purduerov/X19-Control-Board/Design_Information/board_control_quick_notes.txt

Board Quick Notes:

- There is plenty of space
- The connector location needs to be changed, I am not routing into that

- Aman CAN thing
