purduerov/X19-Control-Board/X19-Control-Board.kicad_pcb

## KiCad design X19-Control-Board.kicad_pcb (2026-11-05)

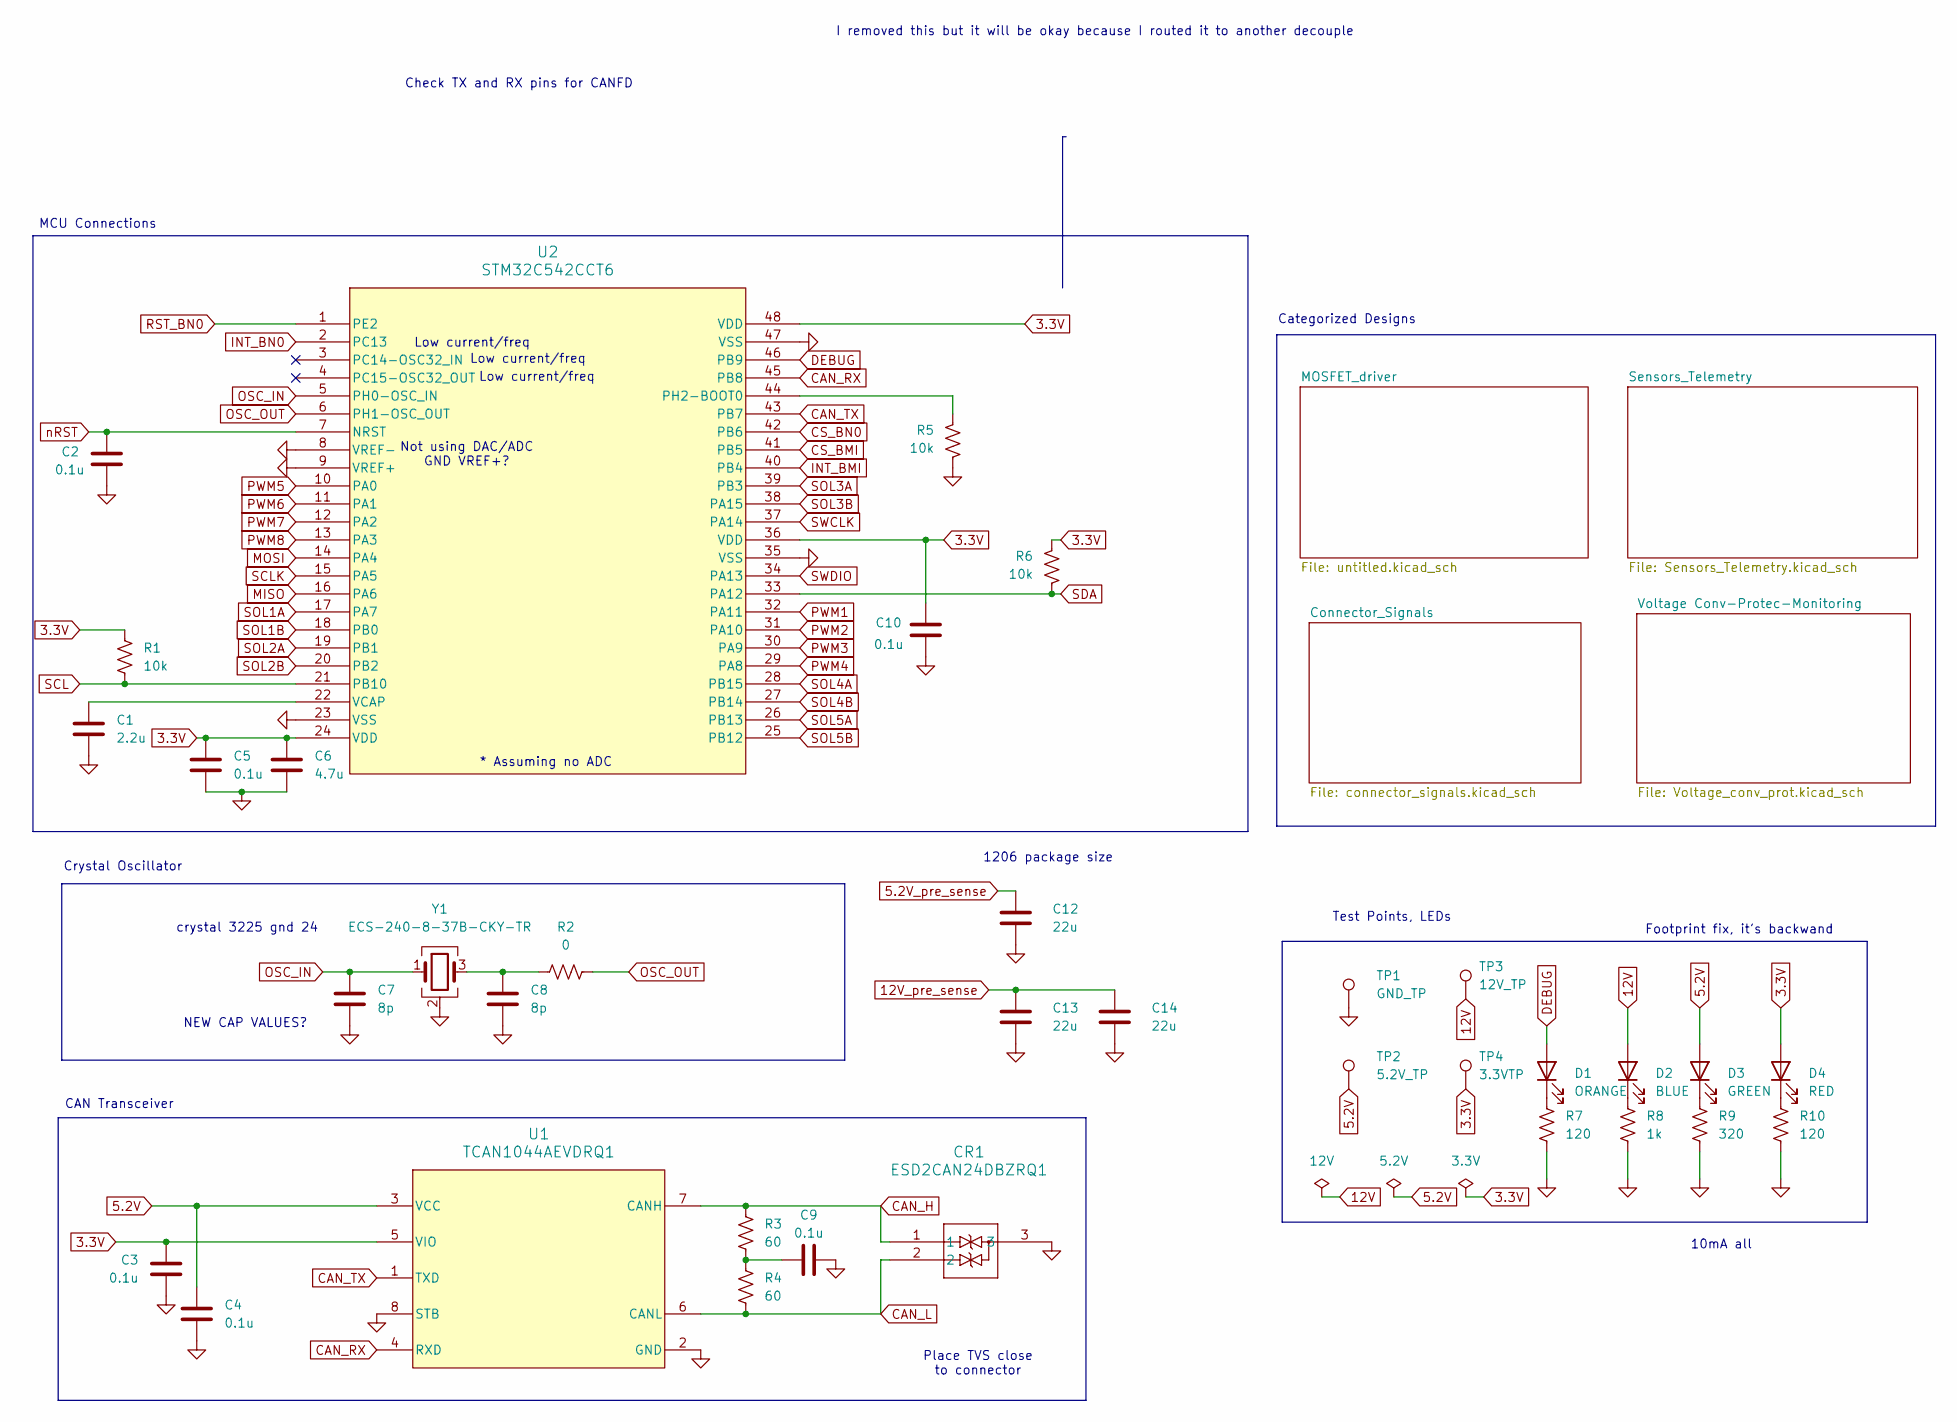
[picture p1: schematic X19-Control-Board.kicad_sch, Purdue ROV Subsystem Board]

Parts:
C1: 2.2u; C_0603_1608Metric_Pad1.08x0.95mm_HandSolder
C2, C3, C4, C5, C9, C10: 0.1u; C_0603_1608Metric_Pad1.08x0.95mm_HandSolder
C6: 4.7u; C_0603_1608Metric_Pad1.08x0.95mm_HandSolder
C7, C8: 8p; C_0603_1608Metric_Pad1.08x0.95mm_HandSolder
C12, C13, C14: 22u; C_1206_3216Metric_Pad1.33x1.80mm_HandSolder
CR1: ESD2CAN24DBZRQ1
D1: ORANGE; LTST-C191KFKT_1_anode_2_cathode
D2: BLUE; LTST-C191KFKT_1_anode_2_cathode
D3: GREEN; LTST-C191KFKT_1_anode_2_cathode
D4: RED; LTST-C191KFKT_1_anode_2_cathode
R1, R5, R6: 10k; R_0603_1608Metric_Pad0.98x0.95mm_HandSolder
R2: 0; R_0603_1608Metric_Pad0.98x0.95mm_HandSolder
R3, R4: 60; R_0603_1608Metric_Pad0.98x0.95mm_HandSolder
R7, R10: 120; R_0603_1608Metric_Pad0.98x0.95mm_HandSolder
R8: 1k; R_0603_1608Metric_Pad0.98x0.95mm_HandSolder
R9: 320; R_0603_1608Metric_Pad0.98x0.95mm_HandSolder
TP1: GND_TP; TestPoint_Pad_D3.0mm
TP2: 5.2V_TP; TestPoint_Pad_D3.0mm
TP3: 12V_TP; TestPoint_Pad_D3.0mm
TP4: 3.3VTP; TestPoint_Pad_D3.0mm
U1: TCAN1044AEVDRQ1
U2: STM32C542CCT6
Y1: ECS-240-8-37B-CKY-TR; ECS-240-8-37CKM_ECS

Connections:
3.3V: C3.1, C5.1, C6.1, C10.2, D4.2 (A), R1.1, R6.1, TP4.1 (1_1), U1.5 (VIO), U2.24 (VDD), U2.36 (VDD), U2.48 (VDD); also elsewhere on the board
5.2V: C4.1, D3.2 (A), TP2.1 (1_1), U1.3 (VCC); also elsewhere on the board
5.2V_pre_sense: C12.1; also elsewhere on the board
12V: D2.2 (A), TP3.1 (1_1); also elsewhere on the board
12V_pre_sense: C13.1, C14.1; also elsewhere on the board
CAN_H: CR1.1, R3.1, U1.7 (CANH); also elsewhere on the board
CAN_L: CR1.2, R4.2, U1.6 (CANL); also elsewhere on the board
CAN_RX: U1.4 (RXD), U2.45 (PB8)
CAN_TX: U1.1 (TXD), U2.43 (PB7)
CS_BMI: U2.41 (PB5); also elsewhere on the board
CS_BN0: U2.42 (PB6); also elsewhere on the board
DEBUG: D1.2 (A), U2.46 (PB9)
GND: C1.2, C2.1, C3.2, C4.2, C5.2, C6.2, C7.2, C8.2, C9.2, C10.1, C12.2, C13.2, C14.2, CR1.3, R5.2, R7.2, R8.2, R9.2, R10.2, TP1.1 (1_1), U1.2 (GND), U1.8 (STB), U2.8 (VREF-), U2.9 (VREF+), U2.23 (VSS), U2.35 (VSS), U2.47 (VSS), Y1.2 (G), Y1.4 (G); also elsewhere on the board
INT_BMI: U2.40 (PB4); also elsewhere on the board
INT_BN0: U2.2 (PC13); also elsewhere on the board
MISO: U2.16 (PA6); also elsewhere on the board
MOSI: U2.14 (PA4); also elsewhere on the board
unnamed: C8.1, R2.1, Y1.3
unnamed: C9.1, R3.2, R4.1
unnamed: D1.1 (K), R7.1
unnamed: D2.1 (K), R8.1
unnamed: D3.1 (K), R9.1
unnamed: D4.1 (K), R10.1
unnamed: R5.1, U2.44 (PH2-BOOT0)
unnamed: C1.1, U2.22 (VCAP)
OSC_IN: C7.1, U2.5 (PH0-OSC_IN), Y1.1
OSC_OUT: R2.2, U2.6 (PH1-OSC_OUT)
PWM1: U2.32 (PA11); also elsewhere on the board
PWM2: U2.31 (PA10); also elsewhere on the board
PWM3: U2.30 (PA9); also elsewhere on the board
PWM4: U2.29 (PA8); also elsewhere on the board
PWM5: U2.10 (PA0); also elsewhere on the board
PWM6: U2.11 (PA1); also elsewhere on the board
PWM7: U2.12 (PA2); also elsewhere on the board
PWM8: U2.13 (PA3); also elsewhere on the board
RST_BN0: U2.1 (PE2); also elsewhere on the board
SCL: R1.2, U2.21 (PB10); also elsewhere on the board
SCLK: U2.15 (PA5); also elsewhere on the board
SDA: R6.2, U2.33 (PA12); also elsewhere on the board
SOL1A: U2.17 (PA7); also elsewhere on the board
SOL1B: U2.18 (PB0); also elsewhere on the board
SOL2A: U2.19 (PB1); also elsewhere on the board
SOL2B: U2.20 (PB2); also elsewhere on the board
SOL3A: U2.39 (PB3); also elsewhere on the board
SOL3B: U2.38 (PA15); also elsewhere on the board
SOL4A: U2.28 (PB15); also elsewhere on the board
SOL4B: U2.27 (PB14); also elsewhere on the board
SOL5A: U2.26 (PB13); also elsewhere on the board
SOL5B: U2.25 (PB12); also elsewhere on the board
SWCLK: U2.37 (PA14); also elsewhere on the board
SWDIO: U2.34 (PA13); also elsewhere on the board
nRST: C2.2, U2.7 (NRST); also elsewhere on the board

Notes on the sheet:
Test Points, LEDs
Low current/freq
I removed this but it will be okay because I routed it to another decouple
CAN Transceiver
* Assuming no ADC
1206 package size
Crystal Oscillator
Not using DAC/ADC GND VREF+?
NEW CAP VALUES?
Check TX and RX pins for CANFD
MCU Connections
10mA all
crystal 3225 gnd 24
Footprint fix, it's backwand
Place TVS close to connector
Categorized Designs

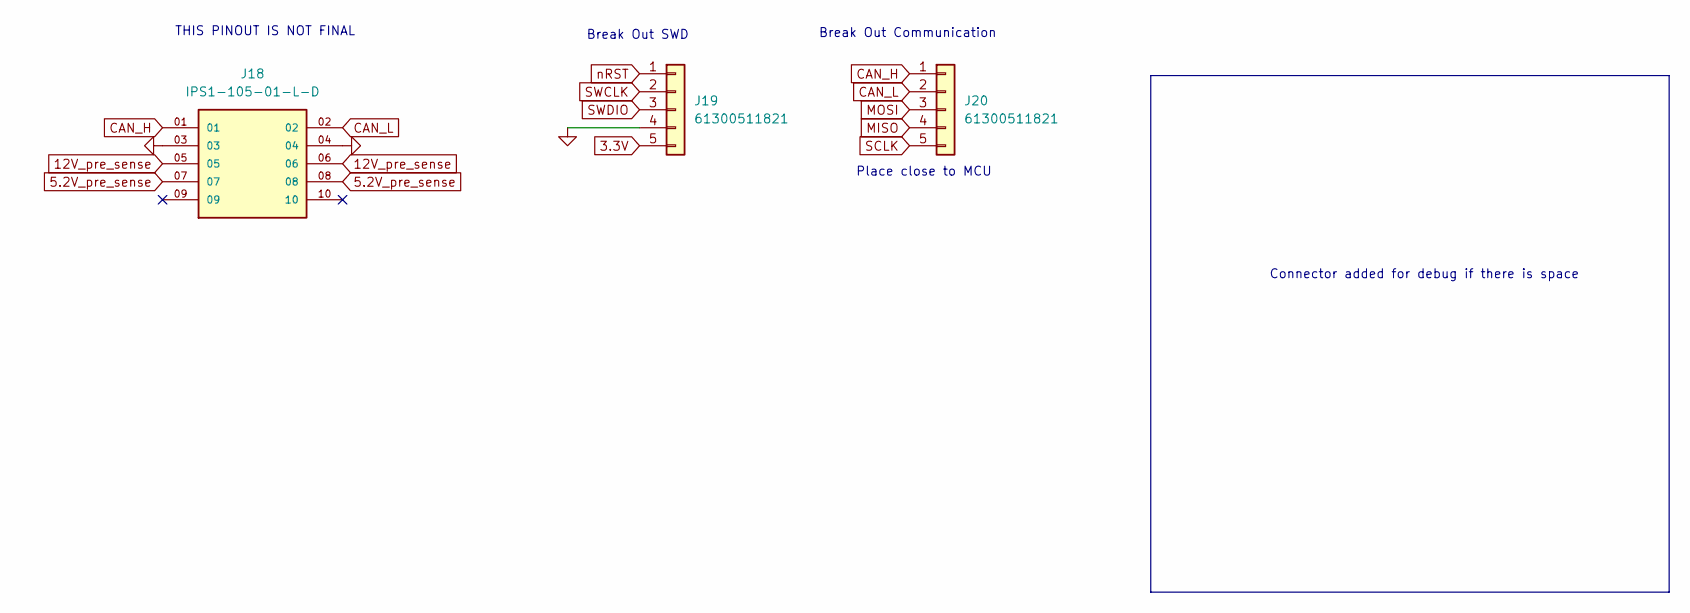
[picture p2: schematic connector_signals.kicad_sch]

Parts:
J18: IPS1-105-01-L-D; SAMTEC_IPS1-105-01-S-D; PARTREV R
J19, J20: 61300511821

Connections:
3.3V: J19.5; also elsewhere on the board
5.2V_pre_sense: J18.07, J18.08; also elsewhere on the board
12V_pre_sense: J18.05, J18.06; also elsewhere on the board
CAN_H: J18.01, J20.1; also elsewhere on the board
CAN_L: J18.02, J20.2; also elsewhere on the board
GND: J18.03, J18.04, J19.4; also elsewhere on the board
MISO: J20.4; also elsewhere on the board
MOSI: J20.3; also elsewhere on the board
SCLK: J20.5; also elsewhere on the board
SWCLK: J19.2; also elsewhere on the board
SWDIO: J19.3; also elsewhere on the board
nRST: J19.1; also elsewhere on the board

Notes on the sheet:
Break Out Communication
Place close to MCU
Connector added for debug if there is space
THIS PINOUT IS NOT FINAL
Break Out SWD

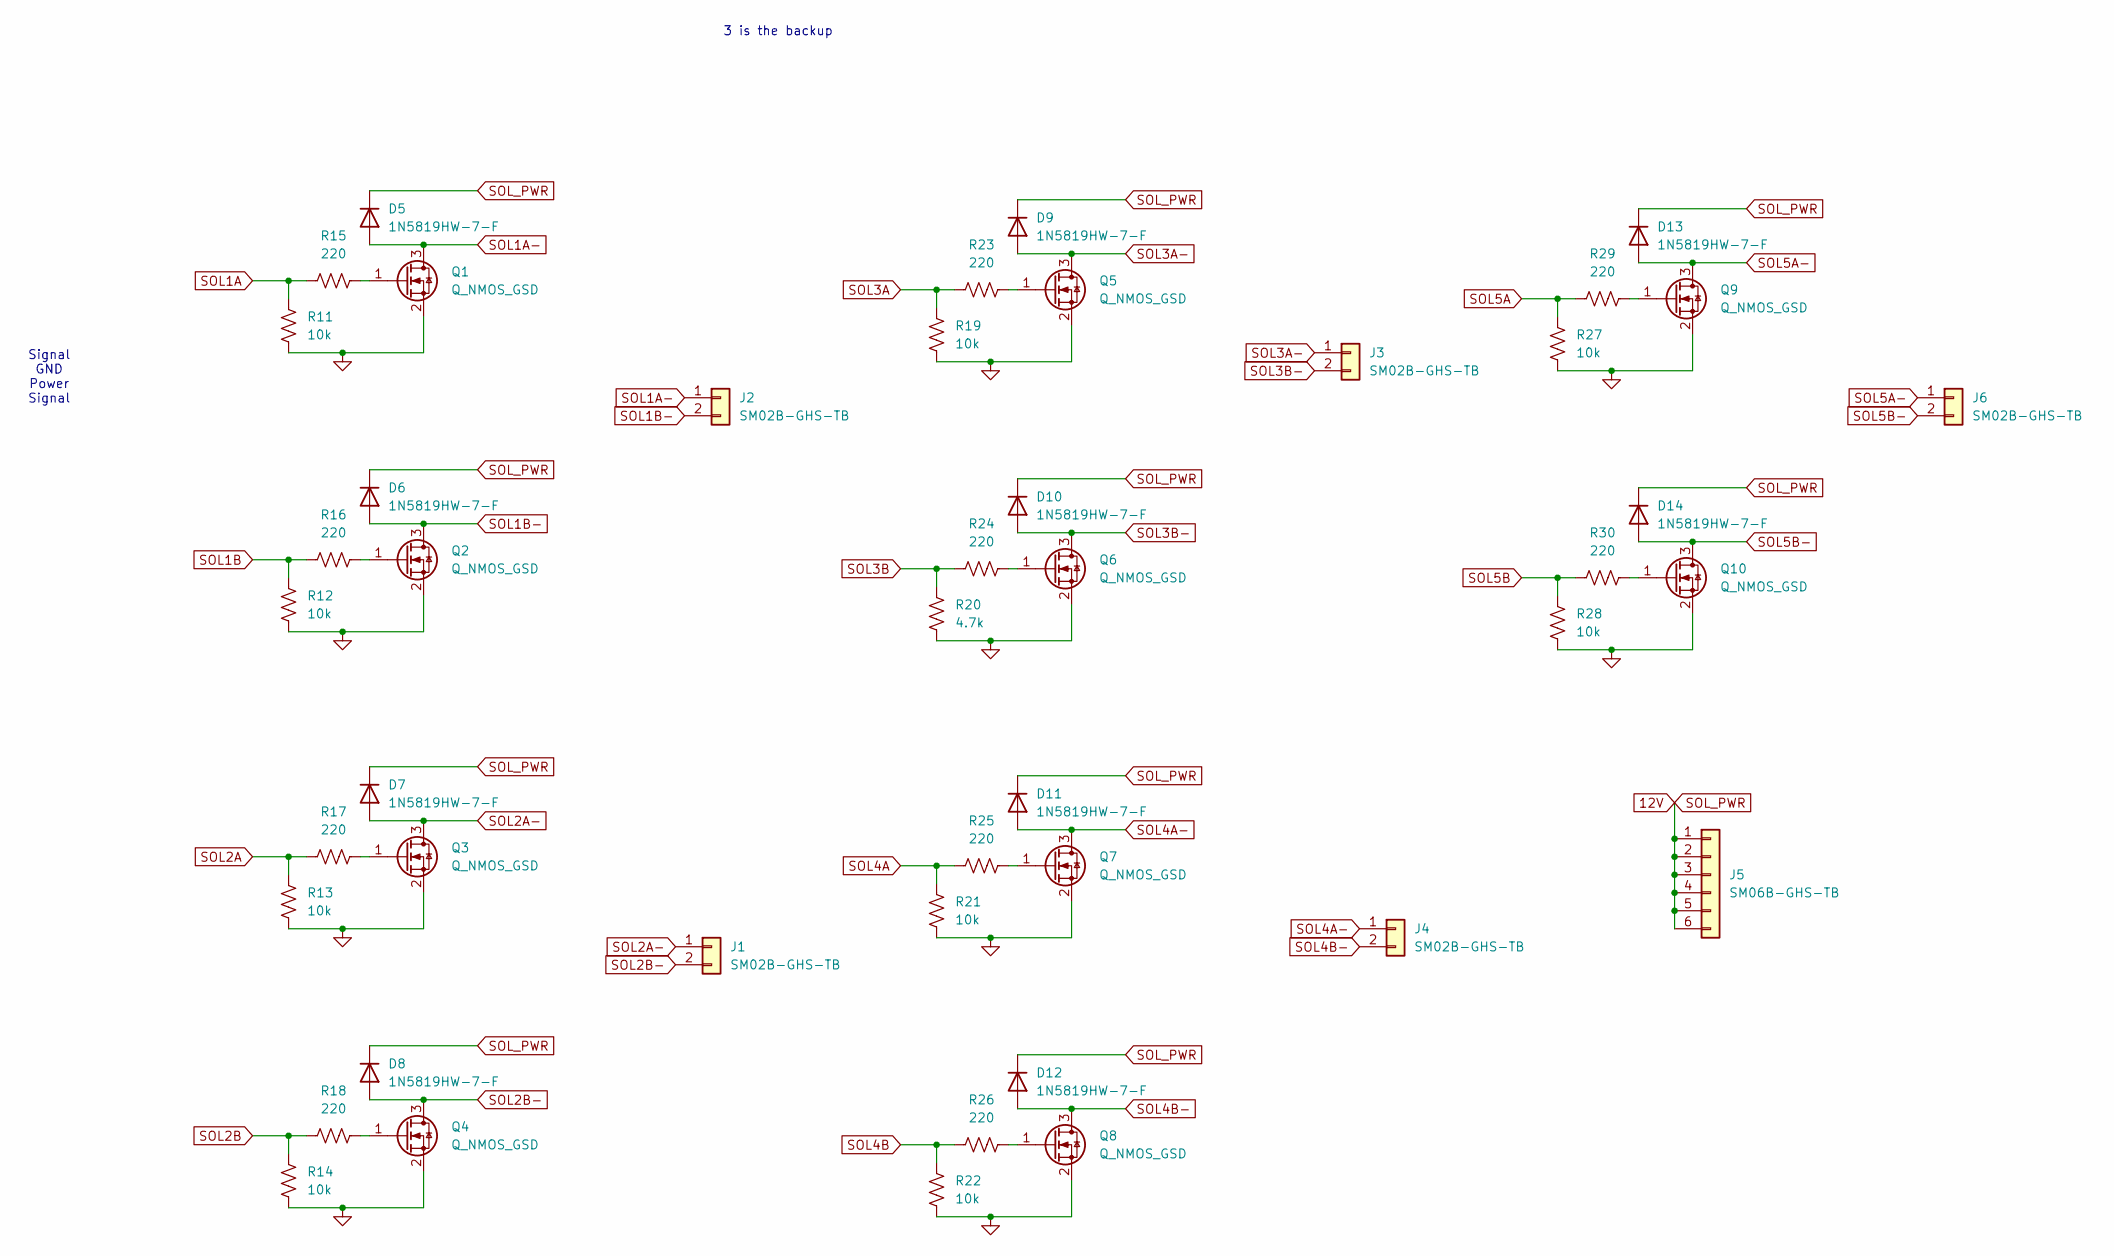
[picture p3: schematic untitled.kicad_sch]

Parts:
D5, D6, D7, D8, D9, D10, D11, D12, D13, D14: 1N5819HW-7-F; 1N5819HW-7-F_DIO
J1, J2, J3, J4, J6: SM02B-GHS-TB; Vertical_CONN_BM02B-GHS-TBT_JST
J5: SM06B-GHS-TB; vertical_CONN_BM06B-GHS-TBT_JST
Q1, Q2, Q3, Q4, Q5, Q6, Q7, Q8, Q9, Q10: Q_NMOS_GSD; SOT-23-3L_AOS
R11, R12, R13, R14, R19, R21, R22, R27, R28: 10k; R_0603_1608Metric_Pad0.98x0.95mm_HandSolder
R15, R16, R17, R18, R23, R24, R25, R26, R29, R30: 220; R_0603_1608Metric_Pad0.98x0.95mm_HandSolder
R20: 4.7k; R_0603_1608Metric_Pad0.98x0.95mm_HandSolder

Connections:
12V: D5.1 (K), D6.1 (K), D7.1 (K), D8.1 (K), D9.1 (K), D10.1 (K), D11.1 (K), D12.1 (K), D13.1 (K), D14.1 (K), J5.1, J5.2, J5.3, J5.4, J5.5, J5.6; also elsewhere on the board
GND: Q1.2 (S), Q2.2 (S), Q3.2 (S), Q4.2 (S), Q5.2 (S), Q6.2 (S), Q7.2 (S), Q8.2 (S), Q9.2 (S), Q10.2 (S), R11.2, R12.2, R13.2, R14.2, R19.2, R20.2, R21.2, R22.2, R27.2, R28.2; also elsewhere on the board
unnamed: Q1.1 (G), R15.2
unnamed: Q2.1 (G), R16.2
unnamed: Q3.1 (G), R17.2
unnamed: Q4.1 (G), R18.2
unnamed: Q5.1 (G), R23.2
unnamed: Q6.1 (G), R24.2
unnamed: Q7.1 (G), R25.2
unnamed: Q8.1 (G), R26.2
unnamed: Q9.1 (G), R29.2
unnamed: Q10.1 (G), R30.2
SOL1A: R11.1, R15.1; also elsewhere on the board
SOL1A-: D5.2 (A), J2.1, Q1.3 (D)
SOL1B: R12.1, R16.1; also elsewhere on the board
SOL1B-: D6.2 (A), J2.2, Q2.3 (D)
SOL2A: R13.1, R17.1; also elsewhere on the board
SOL2A-: D7.2 (A), J1.1, Q3.3 (D)
SOL2B: R14.1, R18.1; also elsewhere on the board
SOL2B-: D8.2 (A), J1.2, Q4.3 (D)
SOL3A: R19.1, R23.1; also elsewhere on the board
SOL3A-: D9.2 (A), J3.1, Q5.3 (D)
SOL3B: R20.1, R24.1; also elsewhere on the board
SOL3B-: D10.2 (A), J3.2, Q6.3 (D)
SOL4A: R21.1, R25.1; also elsewhere on the board
SOL4A-: D11.2 (A), J4.1, Q7.3 (D)
SOL4B: R22.1, R26.1; also elsewhere on the board
SOL4B-: D12.2 (A), J4.2, Q8.3 (D)
SOL5A: R27.1, R29.1; also elsewhere on the board
SOL5A-: D13.2 (A), J6.1, Q9.3 (D)
SOL5B: R28.1, R30.1; also elsewhere on the board
SOL5B-: D14.2 (A), J6.2, Q10.3 (D)

Notes on the sheet:
3 is the backup
Signal GND Power Signal

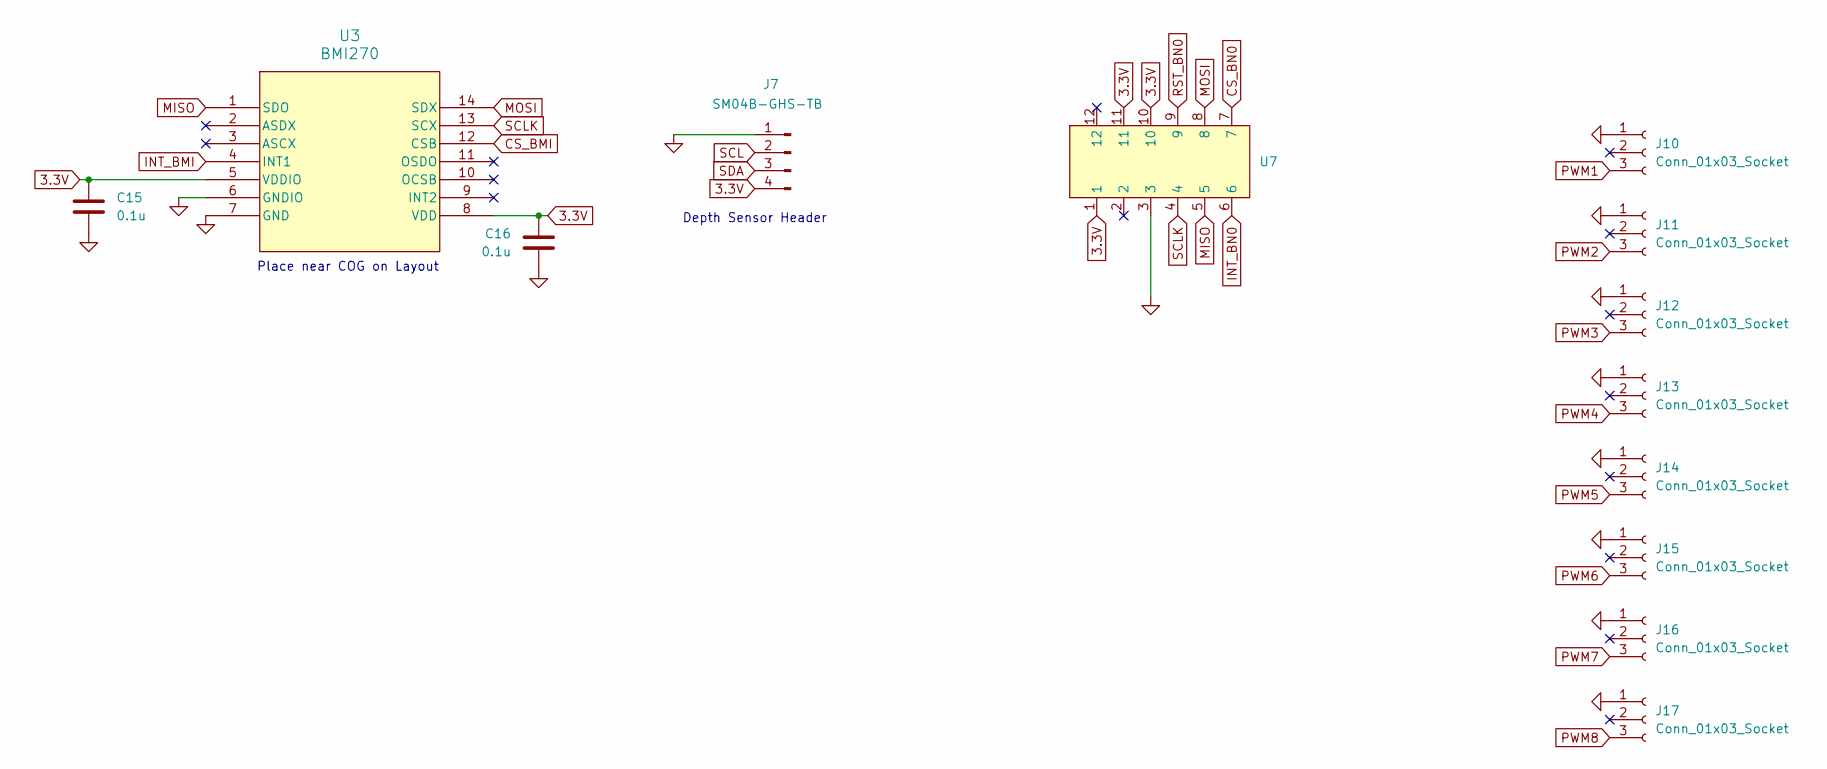
[picture p4: schematic Sensors_Telemetry.kicad_sch]

Parts:
C15, C16: 0.1u; C_0603_1608Metric_Pad1.08x0.95mm_HandSolder
J7: SM04B-GHS-TB; vertical_CONN_BM04B-GHS-TBT_JST
J10, J11, J12, J13, J14, J15, J16, J17: Conn_01x03_Socket; PinHeader_1x03_P2.54mm_Vertical
U3: BMI270; BMI270_BOS
U7: MODULE_4754

Connections:
3.3V: C15.1, C16.1, J7.4, U3.5 (VDDIO), U3.8 (VDD), U7.1, U7.10, U7.11; also elsewhere on the board
CS_BMI: U3.12 (CSB); also elsewhere on the board
CS_BN0: U7.7; also elsewhere on the board
GND: C15.2, C16.2, J7.1, J10.1, J11.1, J12.1, J13.1, J14.1, J15.1, J16.1, J17.1, U3.6 (GNDIO), U3.7 (GND), U7.3; also elsewhere on the board
INT_BMI: U3.4 (INT1); also elsewhere on the board
INT_BN0: U7.6; also elsewhere on the board
MISO: U3.1 (SDO), U7.5; also elsewhere on the board
MOSI: U3.14 (SDX), U7.8; also elsewhere on the board
PWM1: J10.3; also elsewhere on the board
PWM2: J11.3; also elsewhere on the board
PWM3: J12.3; also elsewhere on the board
PWM4: J13.3; also elsewhere on the board
PWM5: J14.3; also elsewhere on the board
PWM6: J15.3; also elsewhere on the board
PWM7: J16.3; also elsewhere on the board
PWM8: J17.3; also elsewhere on the board
RST_BN0: U7.9; also elsewhere on the board
SCL: J7.2; also elsewhere on the board
SCLK: U3.13 (SCX), U7.4; also elsewhere on the board
SDA: J7.3; also elsewhere on the board

Notes on the sheet:
Place near COG on Layout
Depth Sensor Header

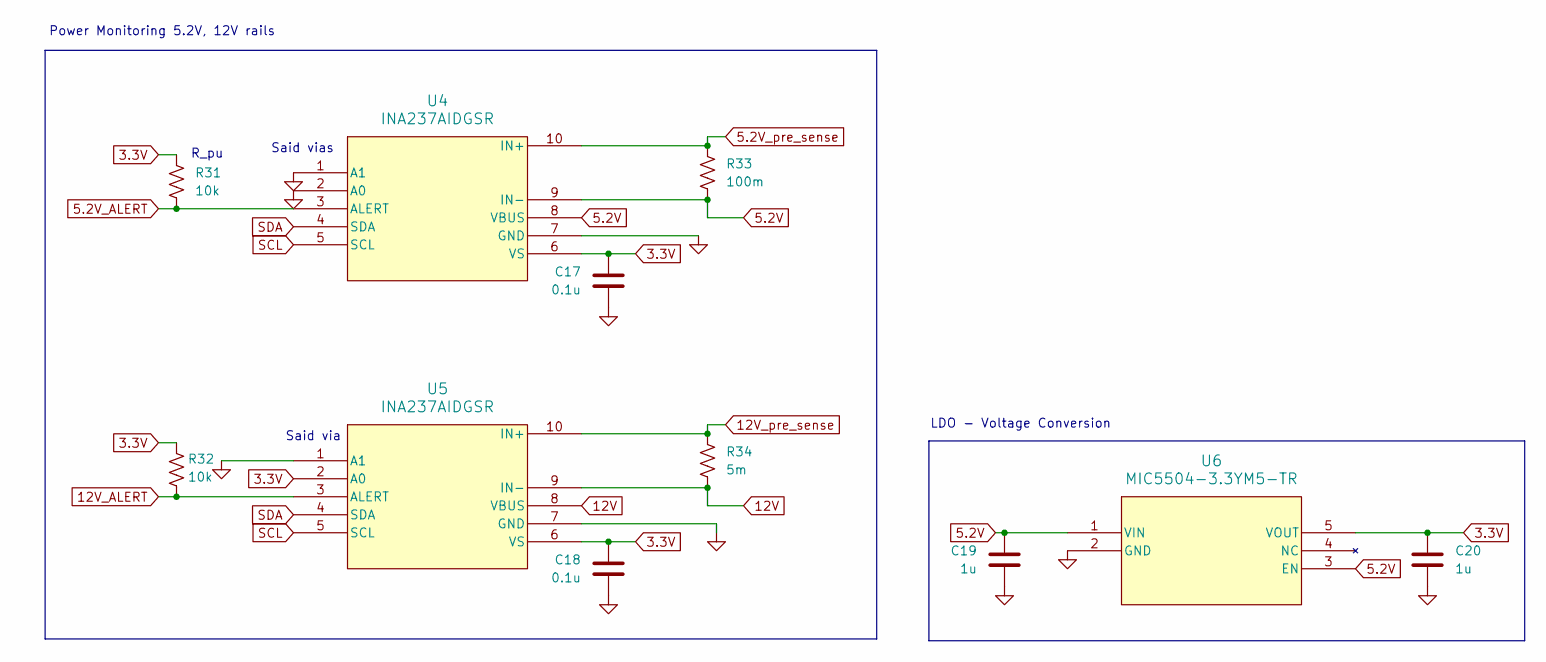
[picture p5: schematic Voltage_conv_prot.kicad_sch]

Parts:
C17, C18: 0.1u; C_0603_1608Metric_Pad1.08x0.95mm_HandSolder
C19, C20: 1u; C_0603_1608Metric_Pad1.08x0.95mm_HandSolder
R31, R32: 10k; R_0603_1608Metric_Pad0.98x0.95mm_HandSolder
R33: 100m; R_0603_1608Metric_Pad0.98x0.95mm_HandSolder
R34: 5m; R_0603_1608Metric_Pad0.98x0.95mm_HandSolder
U4, U5: INA237AIDGSR
U6: MIC5504-3.3YM5-TR; MIC5504_3_3YM5_TR

Connections:
3.3V: C17.1, C18.1, C20.1, R31.1, R32.1, U4.6 (VS), U5.2 (A0), U5.6 (VS), U6.5 (VOUT); also elsewhere on the board
5.2V: C19.1, R33.2, U4.8 (VBUS), U4.9 (IN-), U6.1 (VIN), U6.3 (EN); also elsewhere on the board
5.2V_ALERT: R31.2, U4.3 (ALERT)
5.2V_pre_sense: R33.1, U4.10 (IN+); also elsewhere on the board
12V: R34.2, U5.8 (VBUS), U5.9 (IN-); also elsewhere on the board
12V_ALERT: R32.2, U5.3 (ALERT)
12V_pre_sense: R34.1, U5.10 (IN+); also elsewhere on the board
GND: C17.2, C18.2, C19.2, C20.2, U4.1 (A1), U4.2 (A0), U4.7 (GND), U5.1 (A1), U5.7 (GND), U6.2 (GND); also elsewhere on the board
SCL: U4.5 (SCL), U5.5 (SCL); also elsewhere on the board
SDA: U4.4 (SDA), U5.4 (SDA); also elsewhere on the board

Notes on the sheet:
LDO - Voltage Conversion
Said via
R_pu
Said vias
Power Monitoring 5.2V, 12V rails

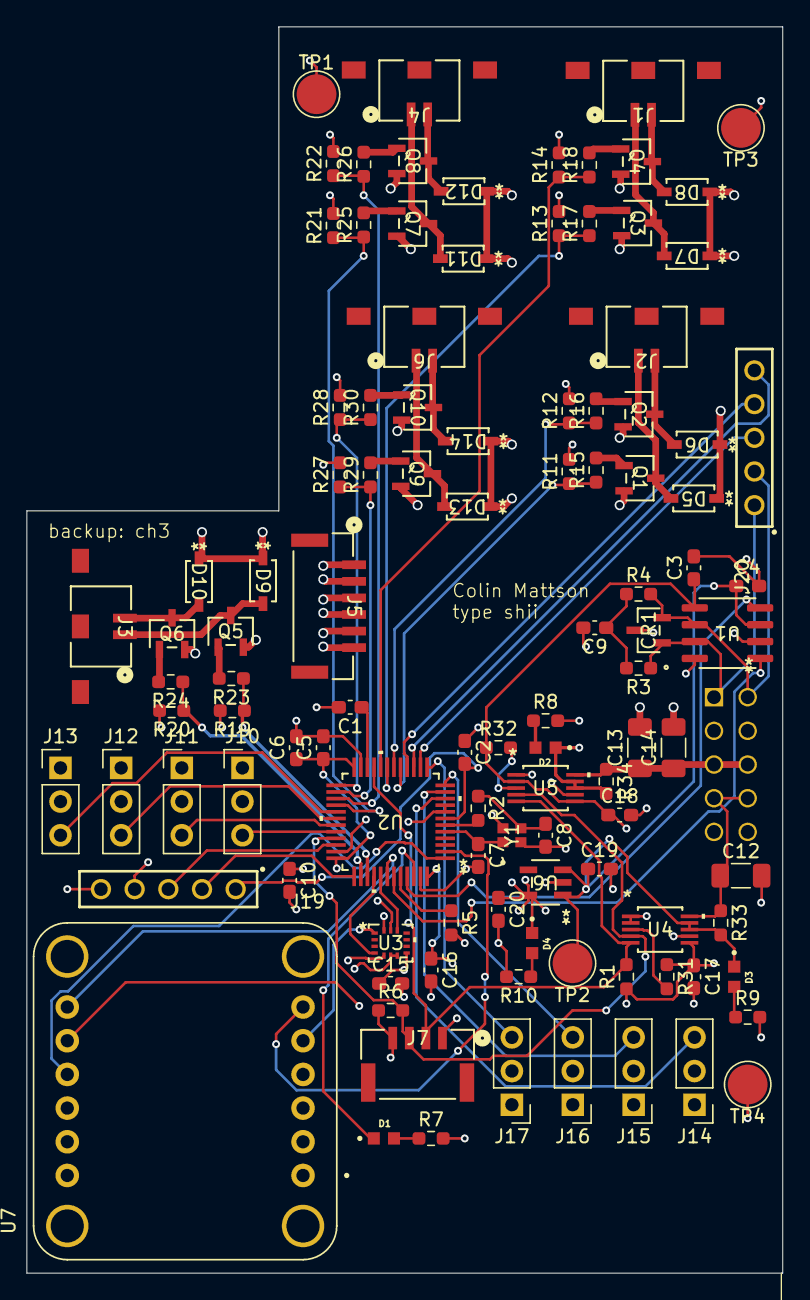
[picture p6: board X19-Control-Board.kicad_pcb from above]

Board: 4 copper layers, 57.0 x 94.0 mm, 108 parts (1 on the bottom side), 74 nets.
