purduerov/X19-Control-Board/(commit log)

2026-08-29 chore: initialize project name to X19_Board_Control and cleanup template config
    [X19_Board_Control.kicad_pcb, X19_Board_Control.kicad_sch]
2026-09-01 refactor: rename project and KiCad files to standardized X19-Control-Board
    [X19-Control-Board.kicad_pcb, X19-Control-Board.kicad_sch]
2026-09-01 chore(ci): update pinned pcb-devops SHA and reflect PDF/BOM outputs in docs
2026-09-01 feat(ci): enable automated GitHub Pages portal and live interactive BOM deployment
2026-09-01 ci: point reusable workflow to pcb-devops@master for zero-maintenance CI propagation
2026-09-01 feat: auto-pull latest board commits with autostash on project launch
2026-09-02 chore(submodule): auto-update purdue-rov-kicad-lib to latest master
2026-09-02 refactor(launcher): proxy root LAUNCH_KICAD scripts directly to central pcb-devops master
2026-09-09 chore(submodule): update purdue-rov-kicad-lib to latest master
2026-09-09 chore(submodule): sync purdue-rov-kicad-lib to 3b036a0
2026-09-09 chore(submodule): sync purdue-rov-kicad-lib to b8f2bd1
2026-09-09 chore(infra): sync goated KiCad launcher, library tables, and purdue-rov-kicad-lib
2026-09-10 Progress 1
    Got some symbols down, need to route things
    [X19_Board_Control.kicad_sch]
2026-09-10 chore(githooks): harden submodule sync and update purdue-rov-kicad-lib
2026-09-10 chore(submodule): update purdue-rov-kicad-lib to d63fa5e
2026-09-10 chore(infra): sync latest infrastructure tooling from board-template
2026-09-10 chore(submodule): sync purdue-rov-kicad-lib to latest master
2026-09-19 Progress Commit
    Aman pls save me
    [X19-Control-Board.kicad_sch]
2026-09-19 chore(submodule): fast-forward purdue-rov-kicad-lib to latest master
2026-09-19 chore(submodule): fast-forward purdue-rov-kicad-lib with BMI270 and BNO085
2026-09-19 chore(submodule): bump purdue-rov-kicad-lib to latest master
2026-09-19 ci: set strict_drc to false to generate PDFs and artifacts for WIP boards
2026-09-19 Mid-day Push
    Progress later
    [X19-Control-Board.kicad_sch, untitled.kicad_sch]
2026-09-20 Much more progress
    hi mom
    [IMU_Circuits.kicad_sch, Power_Monitoring.kicad_sch, Sensors_Telemetry.kicad_sch, Voltage_conv_prot.kicad_sch, X19-Control-Board.kicad_sch, connector_signals.kicad_sch, untitled.kicad_sch]
2026-09-20 More more work
    Hi mom 2
    [LED_TPs.kicad_sch, Voltage_conv_prot.kicad_sch, connector_signals.kicad_sch]
2026-09-20 Final v1
    Finished making it look nice, looking for feedback
    [Voltage_conv_prot.kicad_sch, X19-Control-Board.kicad_sch, connector_signals.kicad_sch]
2026-09-20 Ok I lied v1 for real
    real
    [Sensors_Telemetry.kicad_sch, Voltage_conv_prot.kicad_sch, X19-Control-Board.kicad_sch, connector_signals.kicad_sch, untitled.kicad_sch]
2026-09-20 Nick Initial Feedback - Page 1
    [X19-Control-Board.kicad_sch]
2026-09-21 Commit for Milwaukee Review
    Version 0.2 Completed
    [Power_Monitoring.kicad_sch, Sensors_Telemetry.kicad_sch, Voltage_conv_prot.kicad_sch, X19-Control-Board.kicad_sch, connector_signals.kicad_sch, untitled.kicad_sch]
2026-09-26 feat: adopt ROV PCB platform contract
2026-09-26 ci: grant the reusable update workflow least-privilege permissions
    A reusable workflow can only narrow the caller's token, never widen it, so this
    wrapper has to declare what the called workflow asks for. Without its own
    permissions block the call is clamped to the repository default, which is
    read-only on several boards, and every scheduled library update fails to push
    the update branch or open its pull request while still looking green. The five
    documented inputs are unchanged.
2026-09-26 chore: ignore KiCad project backup archives
2026-10-07 Update ig
    We messed up
    [Sensors_Telemetry.kicad_sch, Voltage_conv_prot.kicad_sch, X19-Control-Board.kicad_sch, connector_signals.kicad_sch, untitled.kicad_sch]
2026-10-12 chore(library): update purdue-rov-kicad-lib submodule
2026-10-26 Small update
    Question about the rst pin for bn0
